WBPBP/ff-arduino/docs/cable-out.jpg

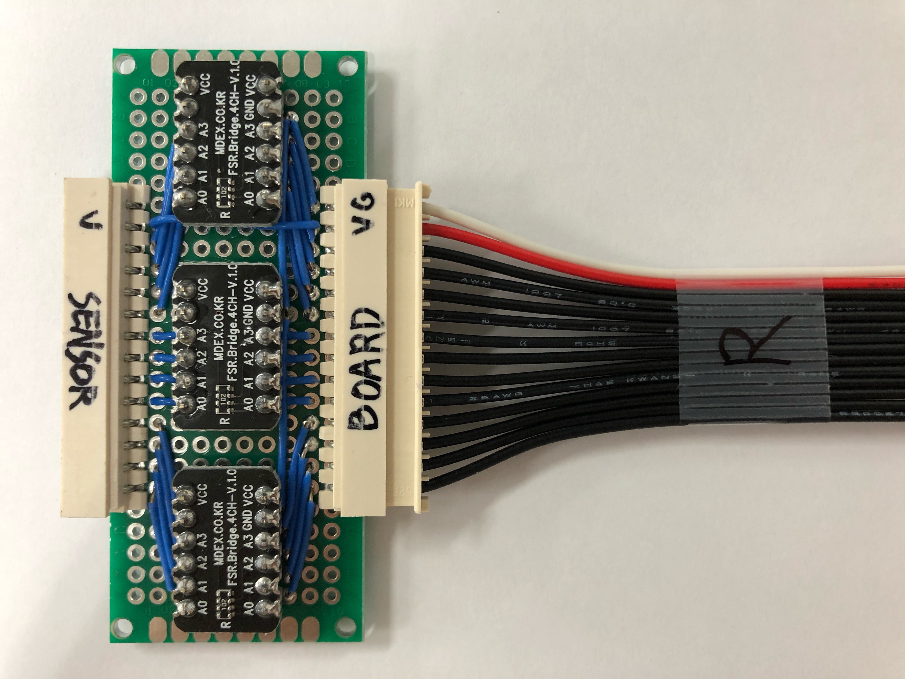
docs/cable-out.jpg
