WBPBP/ff-arduino/docs/foot-scheme.png

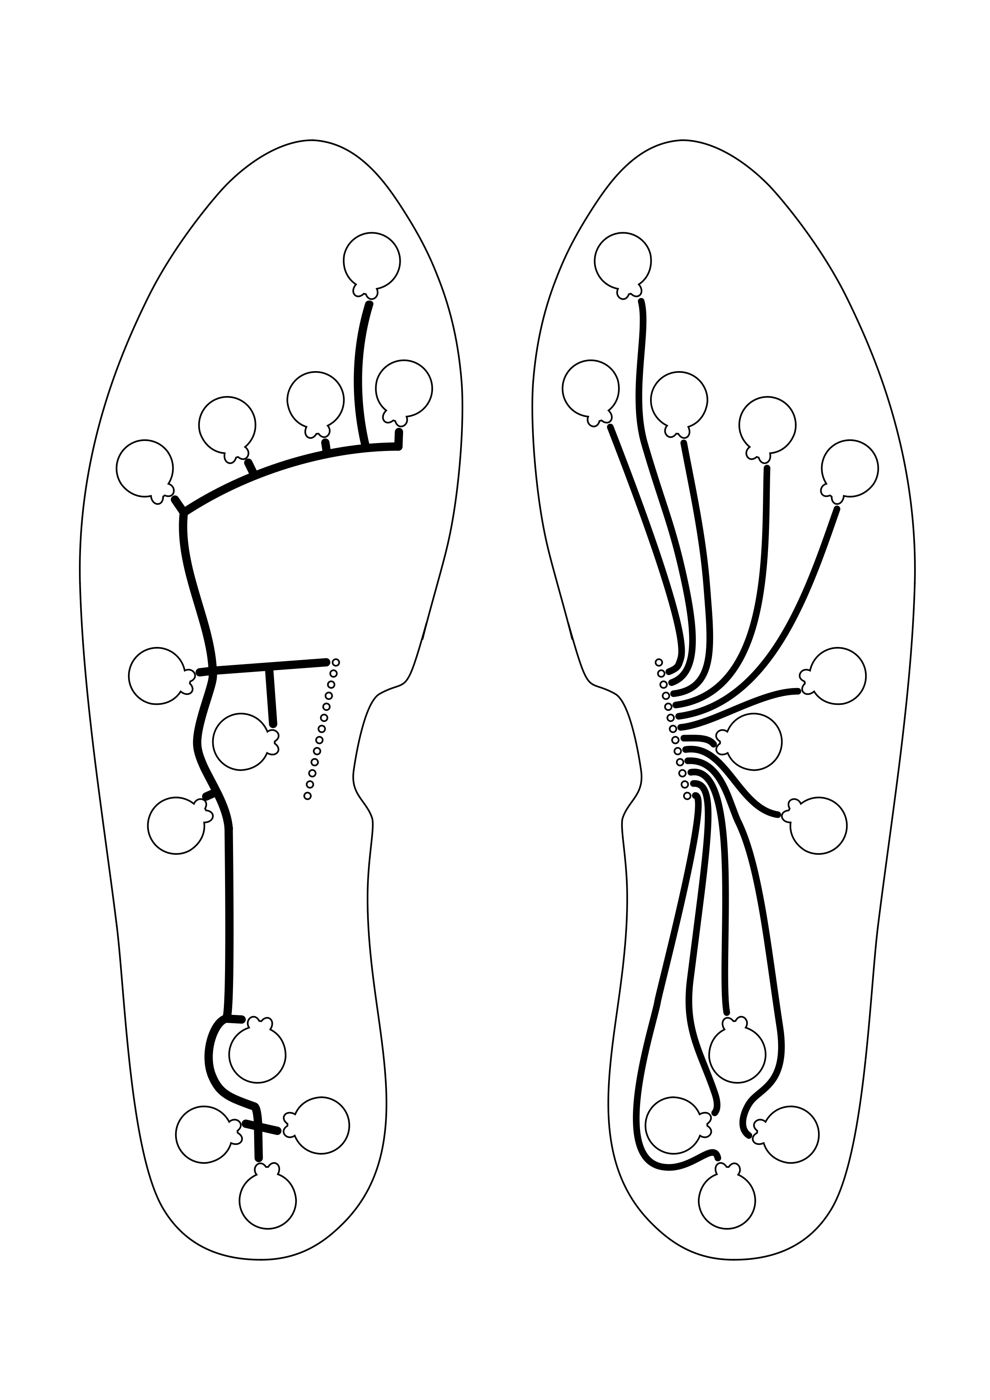
docs/foot-scheme.png
