WBPBP/ff-arduino/config.h

/**
 * Copyright (C) 2020 WBPBP <potados99@gmail.com>
 *
 * This file is part of Preshoes (https://github.com/WBPBP).
 *
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
 * You should have received a copy of the GNU General Public License
 * along with this program.  If not, see <https://www.gnu.org/licenses/>.
 */

#ifndef _config_h
#define _config_h

#define BAUDRATE 115200

#define SAMPLE_MAX 15
#define ADC_VALUE_WHEN_PRESSURE_MAX 2500

#define ADC_VALUE_WHEN_BATTERY_ZERO 2150
#define ADC_VALUE_WHEN_BATTERY_FULL 2333

#define PIN_SENSOR_0  2
#define PIN_SENSOR_1  4
#define PIN_SENSOR_2  15
#define PIN_SENSOR_3  34
#define PIN_SENSOR_4  32
#define PIN_SENSOR_5  33
#define PIN_SENSOR_6  25
#define PIN_SENSOR_7  26
#define PIN_SENSOR_8  14
#define PIN_SENSOR_9  27
#define PIN_SENSOR_10 13
#define PIN_SENSOR_11 12
#define PIN_BATTERY 35

#endif /* _config_h */
