WBPBP/ff-arduino/(commit log)

2020-05-31 normalized sensor data
2020-05-31 Use Serial(0) for communication btw boards
2020-06-06 Add support for battery measurement.
